ppalex7/auto-pump-gyver/README.md

PROJECT_PHOTO
# Простейшая система авто полива
* [Описание проекта](#chapter-0)
* [Папки проекта](#chapter-1)
* [Схемы подключения](#chapter-2)
* [Материалы и компоненты](#chapter-3)
* [Как скачать и прошить](#chapter-4)
* [FAQ](#chapter-5)
* [Полезная информация](#chapter-6)
AlexGyver YouTube (https://www.youtube.com/channel/UCgtAOyEQdAyjvm9ATCi_Aig?sub_confirmation=1)

## Описание проекта
Автополив на Digispark
Особенности:
- Простейшая схема: мосфет модуль и помпа
- Режим глубокого энрегосбережения: 30 мкА в режиме сна
- Недорогая платформа Digispark
- Подробности в видео: https://youtu.be/x6ProAzvT1g

## Папки
**ВНИМАНИЕ! Если это твой первый опыт работы с Arduino, читай [инструкцию](#chapter-4)**
- **libraries** - библиотеки проекта
- **digi_pump** - прошивка из видео
- **digi_servo_sleep** - прошивка для серво (не забудьте установить библиотеку)
- **schemes** - схемы подключения

## Схемы
SCHEME
SCHEME
SCHEME
_Для Digispark с MicroUSB (как на картинке ниже), один диод (обведен) все-таки лучше не отпаивать. Через него питается микроконтроллер при прошивке. Без него прошить все-ещё можно, но придется подавать на схему внешнее питание._
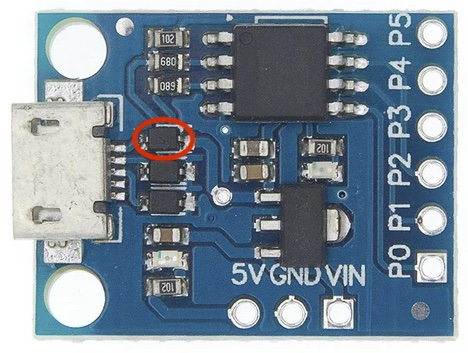
[picture p1: schemes/digispark-microusb.jpg]
SCHEME


## Материалы и компоненты
### Ссылки оставлены на магазины, с которых я закупаюсь уже не один год
### Почти все компоненты можно взять в магазине WAVGAT по первым ссылкам
* Digispark https://aliexpress.ru/item/32807895683.html
* Мосфет модуль https://aliexpress.ru/item/4000550112144.html
* Батарейный отсек 4xAA https://aliexpress.ru/item/32553923147.html
* Отсек 3-4 АА (другой магаз) https://aliexpress.ru/item/32818907820.html
* Отсек как на видео (другой магаз) https://aliexpress.ru/item/32821360423.html
* Помпа https://aliexpress.ru/item/32813225037.html
* Транзисторы, конденсаторы и резисторы – в ЛЮБОМ магазине радиодеталей
* Шланг https://aliexpress.ru/item/32631432356.html
* Шланг (получше) https://aliexpress.ru/item/1005001460435823.html?sku_id=12000018082918768
* Тройнички https://aliexpress.ru/item/32630461456.html
* Разветвитель https://aliexpress.ru/item/32733202587.html

## Вам скорее всего пригодится
* [Всё для пайки (паяльники и примочки)](http://alexgyver.ru/all-for-soldering/)
* [Недорогие инструменты](http://alexgyver.ru/my_instruments/)
* [Все существующие модули и сенсоры Arduino](http://alexgyver.ru/arduino_shop/)
* [Электронные компоненты](http://alexgyver.ru/electronics/)
* [Аккумуляторы и зарядные модули](http://alexgyver.ru/18650/)

## Как скачать и прошить
* [Первые шаги с Arduino](http://alexgyver.ru/arduino-first/) - ультра подробная статья по началу работы с Ардуино, ознакомиться первым делом!
* Скачать архив с проектом
> На главной странице проекта (где ты читаешь этот текст) вверху справа зелёная кнопка **Clone or download**, вот её жми, там будет **Download ZIP**
* Установить библиотеки в  
`C:\Program Files (x86)\Arduino\libraries\` (Windows x64)  
`C:\Program Files\Arduino\libraries\` (Windows x86)
* Подключить Ардуино к компьютеру
* Запустить файл прошивки (который имеет расширение .ino)
* Настроить IDE (COM порт, модель Arduino, как в статье выше)
* Настроить что нужно по проекту
* Нажать загрузить
* Пользоваться  

## Настройки в коде
    #define PERIOD 5       // период работы в секундах
    #define WORK 5         // время работы в секундах
    #define MOS 1          // пин мосфета

## FAQ
### Основные вопросы
В: Как скачать с этого грёбаного сайта?  
О: На главной странице проекта (где ты читаешь этот текст) вверху справа зелёная кнопка **Clone or download**, вот её жми, там будет **Download ZIP**

В: Скачался какой то файл .zip, куда его теперь?  
О: Это архив. Можно открыть стандартными средствами Windows, но думаю у всех на компьютере установлен WinRAR, архив нужно правой кнопкой и извлечь.

В: Я совсем новичок! Что мне делать с Ардуиной, где взять все программы?  
О: Читай и смотри видос http://alexgyver.ru/arduino-first/

В: Вылетает ошибка загрузки / компиляции!
О: Читай тут: https://alexgyver.ru/arduino-first/#step-5

В: Сколько стоит?  
О: Ничего не продаю.

### Вопросы по этому проекту

## Полезная информация
* [Мой сайт](http://alexgyver.ru/)
* [Основной YouTube канал](https://www.youtube.com/channel/UCgtAOyEQdAyjvm9ATCi_Aig?sub_confirmation=1)
* [YouTube канал про Arduino](https://www.youtube.com/channel/UC4axiS76D784-ofoTdo5zOA?sub_confirmation=1)
* [Мои видеоуроки по пайке](https://www.youtube.com/playlist?list=PLOT_HeyBraBuMIwfSYu7kCKXxQGsUKcqR)
* [Мои видеоуроки по Arduino](http://alexgyver.ru/arduino_lessons/)
