ppalex7/auto-pump-gyver/ATtinyPump.md

# Система авто полива

## Описание проекта
Вариант автополива на базе микроконтроллера ATtiny13, который можно собрать на макетной или печатной плате.

## Схемы
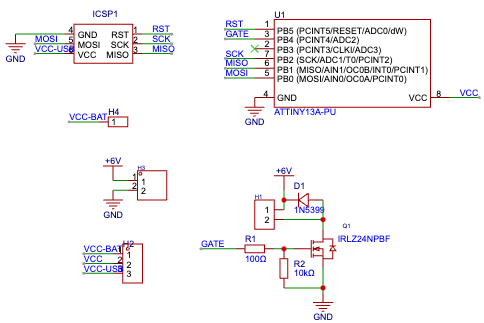
[picture p2: schemes/schematic.png]
schematic

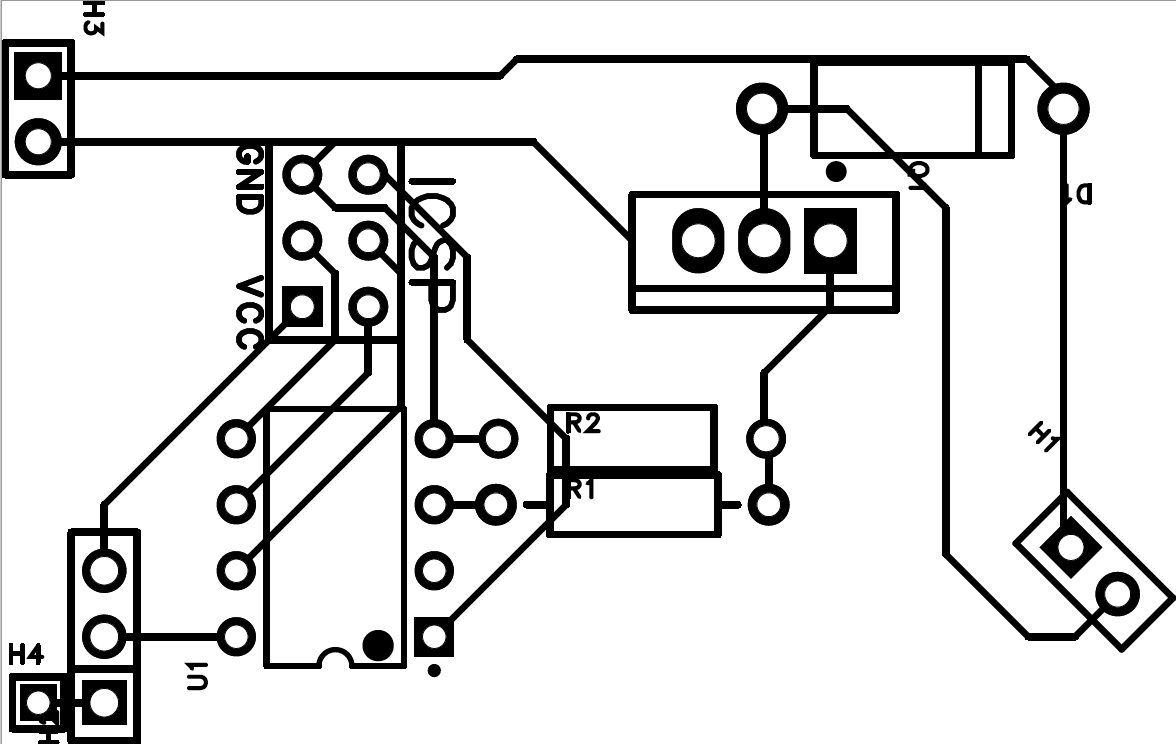
[picture p3: schemes/pcb.png]
pcb


## Особенности
От одних и тех же батареек не заработало: с началом работы помпы микроконтроллер перезагружается.
Должно помочь добавление керамических конденсаторов (0.1-0.2 мкФ):
- по питанию микроконтроллера
- на помпу:
  - параллельно ей самой
  - между плюсом от батареек и подключением плюса помпы
  - между минусом батареек и подключением минуса помпы
