ppalex7/auto-pump-gyver/(commit log)

2024-07-05 Добавить поддержку ATtiny13
    дока к варианту на attiny13
2024-07-05 добавить в README какой диод не стоит отпаивать
2024-07-05 заменить реферральные ссылки на исходные
    (а то непонятно, кому и как за такое отчитываться ¯\_(ツ)_/¯)
2024-07-05 добавить ссылку на другой шланг (более плотный)
